eneavignoli/Dido/Thesis/arduino_mega_description.png

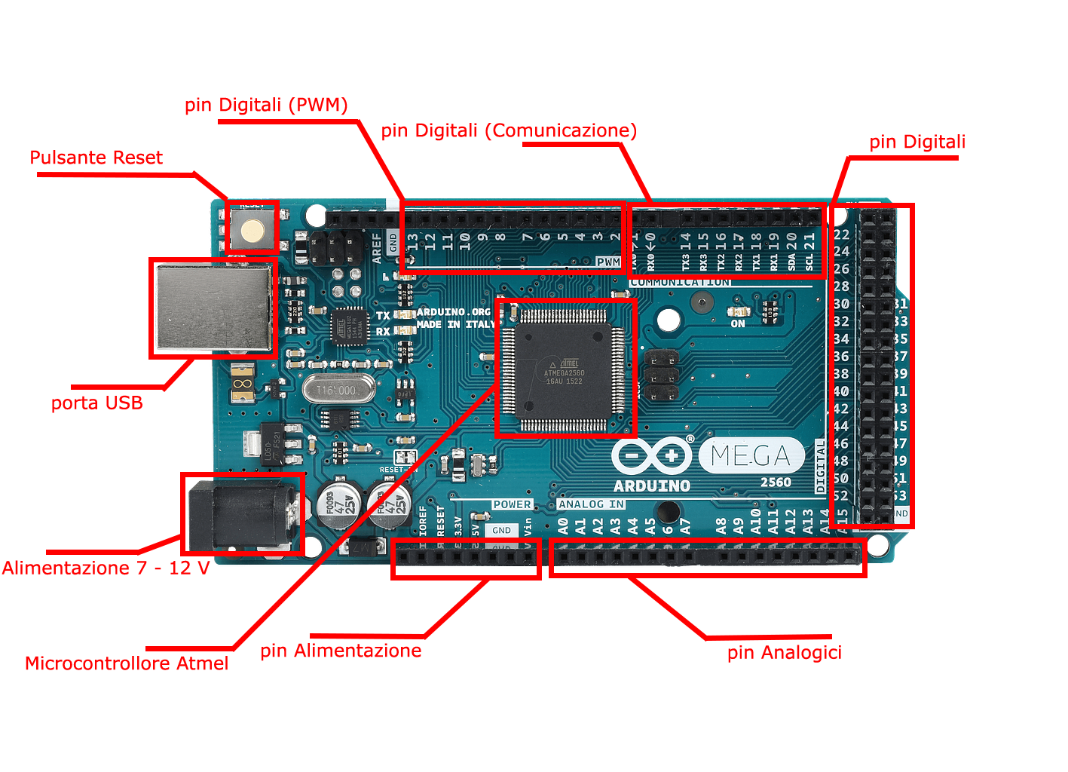
Thesis/arduino_mega_description.png
