eneavignoli/Dido/Thesis/view_board.JPG

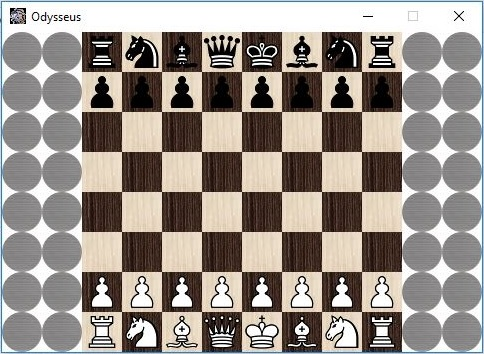
Thesis/view_board.JPG
