eneavignoli/Dido/Presentation/Odysseus.pptx

## Odysseus

Progettazione di un robot che gioca a scacchi

## Un po’ di storia

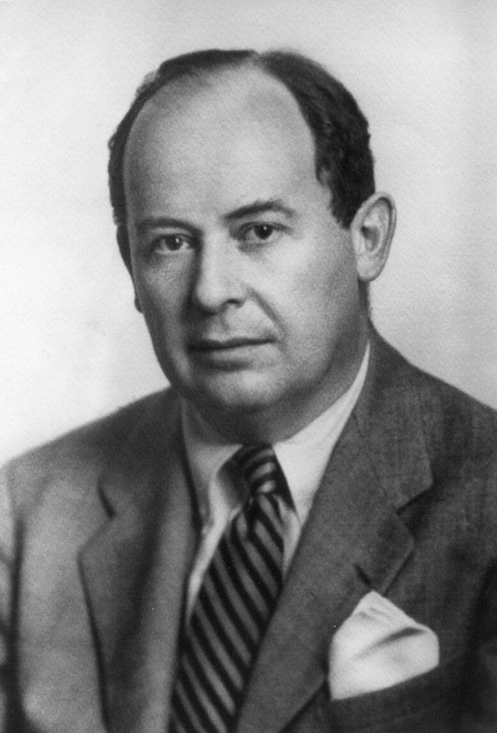
[picture p16: figure]

John Von Neumann

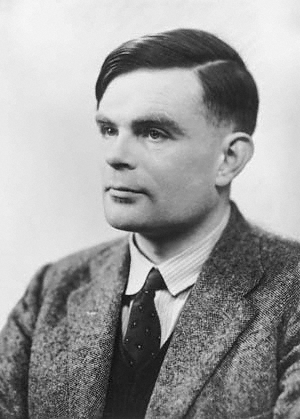
[picture p17: figure]

Alan Turing

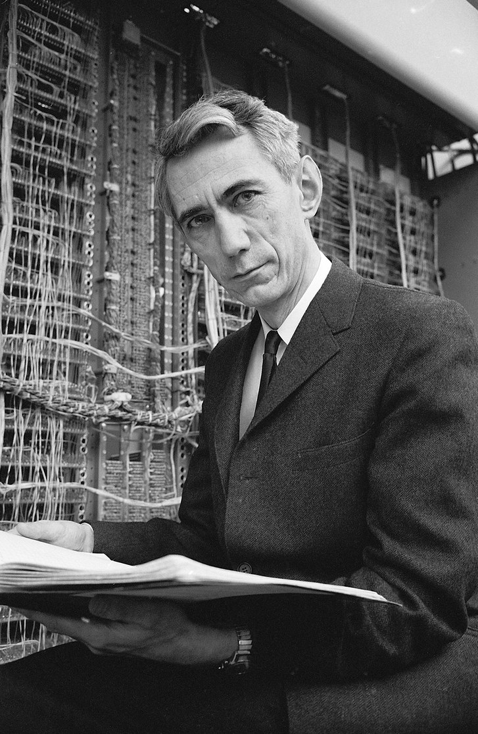
[picture p18: figure]

Claude Shannon

## Uomo e macchina si incontrano

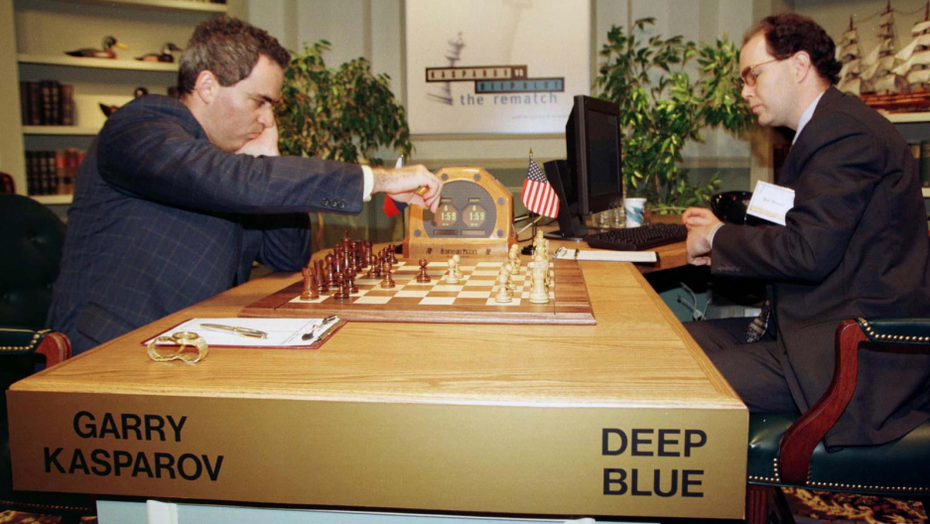
[picture p19: figure]

## Elaboratori


Raspberry Pi 3 Model B


Arduino Mega 2560 Rev3

## Matrice di rilevamento


## Sistema di spostamento

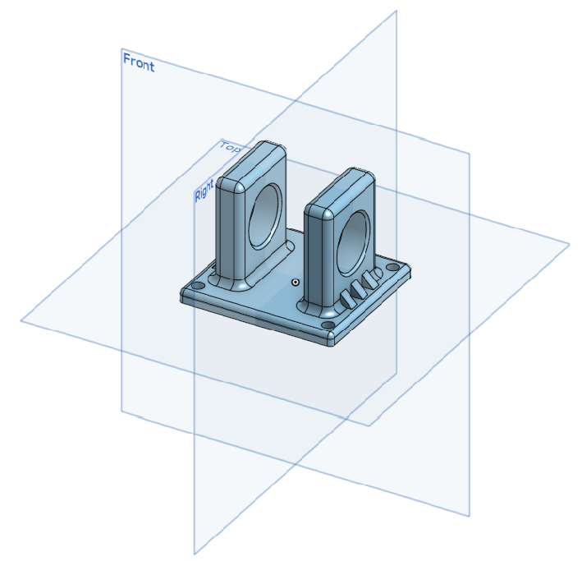
[picture p20: figure]

## Alberi di ricerca

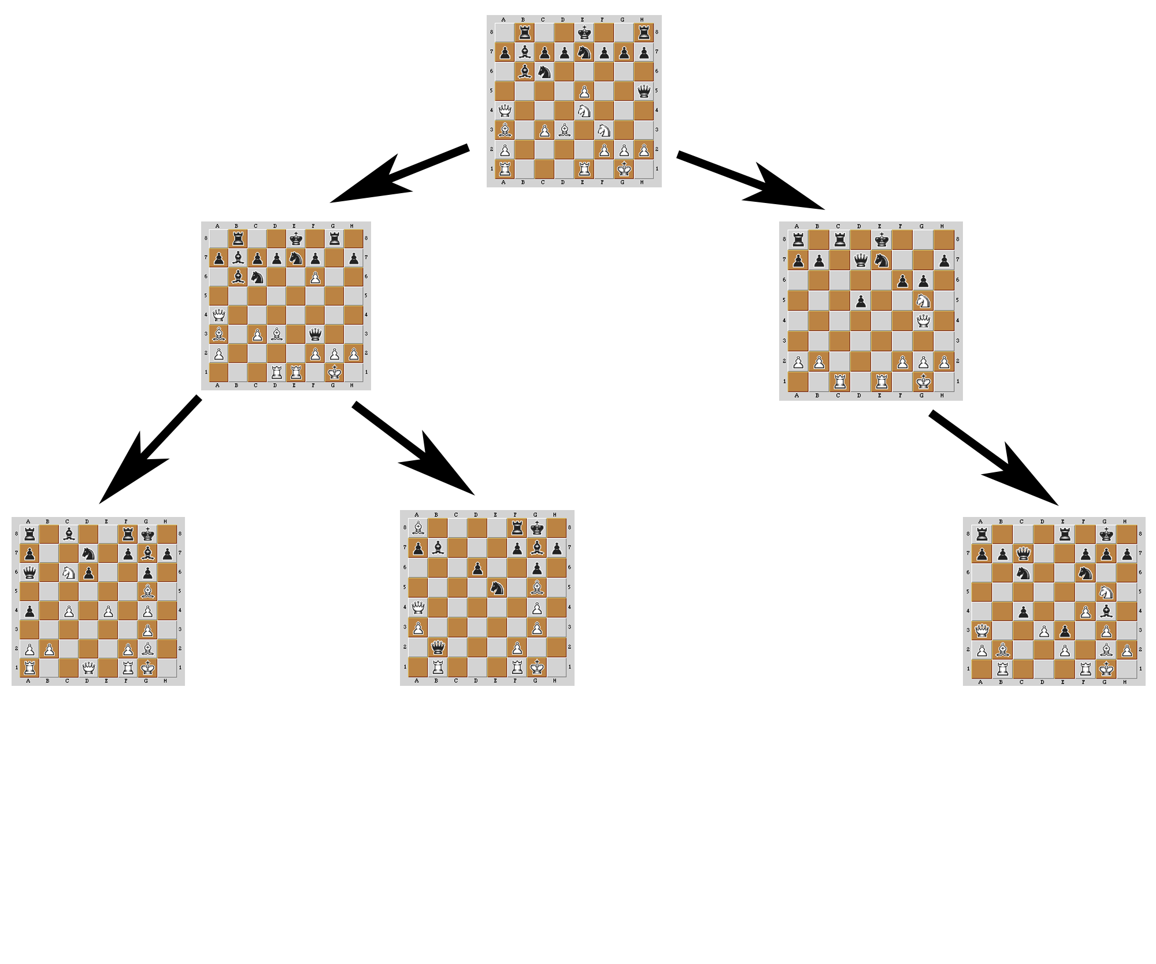
[picture p21: figure]

Nodo «Radice»

Nodi «Foglia»

## Algoritmo Minimax

5

5

-7

10

5

-7
