eneavignoli/Dido/Presentation/garry_kasparov.jpg

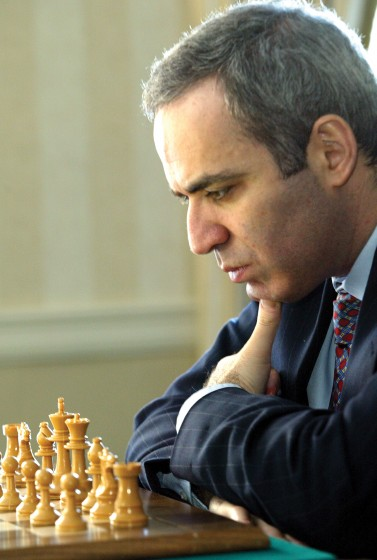
Presentation/garry_kasparov.jpg
