eneavignoli/Dido/Presentation/scacchiera1.gif

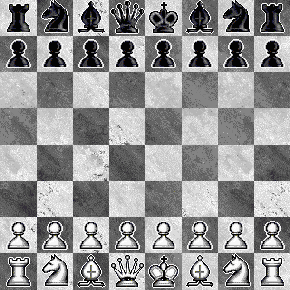
Presentation/scacchiera1.gif
