eneavignoli/Dido/Presentation/scacchiera2.gif

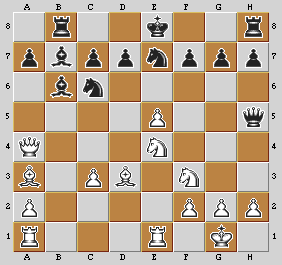
Presentation/scacchiera2.gif
