eneavignoli/Dido/Presentation/scacchiera3.gif

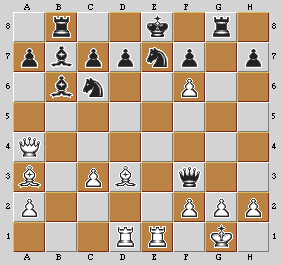
Presentation/scacchiera3.gif
