eneavignoli/Dido/Presentation/scacchiera4.gif

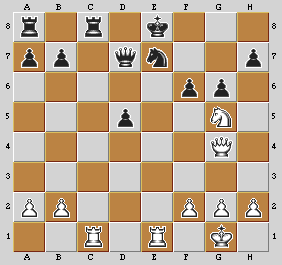
Presentation/scacchiera4.gif
