eneavignoli/Dido/Presentation/scacchiera5.gif

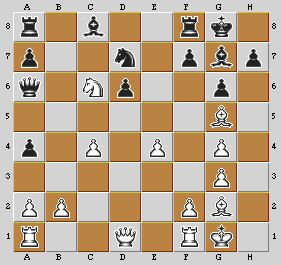
Presentation/scacchiera5.gif
