eneavignoli/Dido/Presentation/scacchiera6.gif

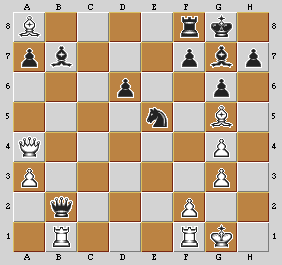
Presentation/scacchiera6.gif
