eneavignoli/Dido/Presentation/scacchiera7.gif

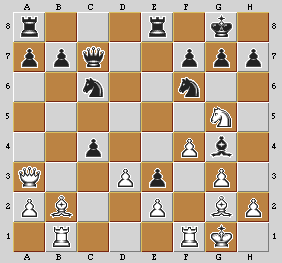
Presentation/scacchiera7.gif
