eneavignoli/Dido/Presentation/scacchiera8.gif

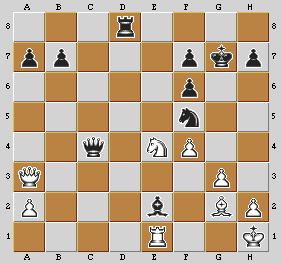
Presentation/scacchiera8.gif
