eneavignoli/Dido/Thesis/electronics_scheme.JPG

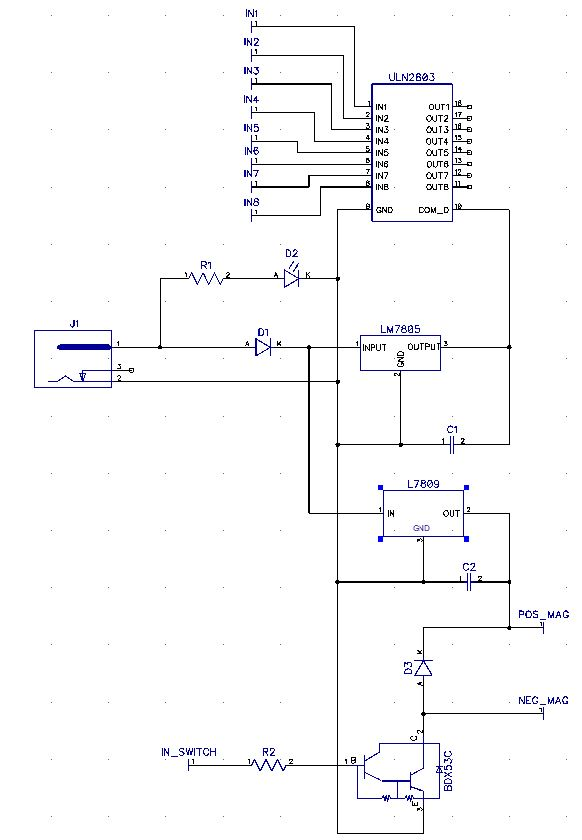
Thesis/electronics_scheme.JPG
