eneavignoli/Dido/Thesis/hall_data.JPG

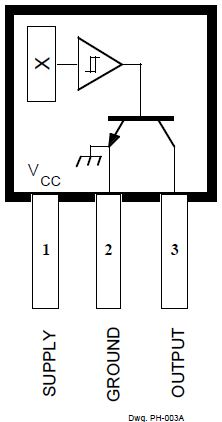
Thesis/hall_data.JPG
