eneavignoli/Dido/Thesis/isytozero.JPG

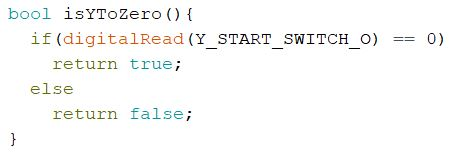
Thesis/isytozero.JPG
