eneavignoli/Dido/Thesis/kumantech_display.jpg

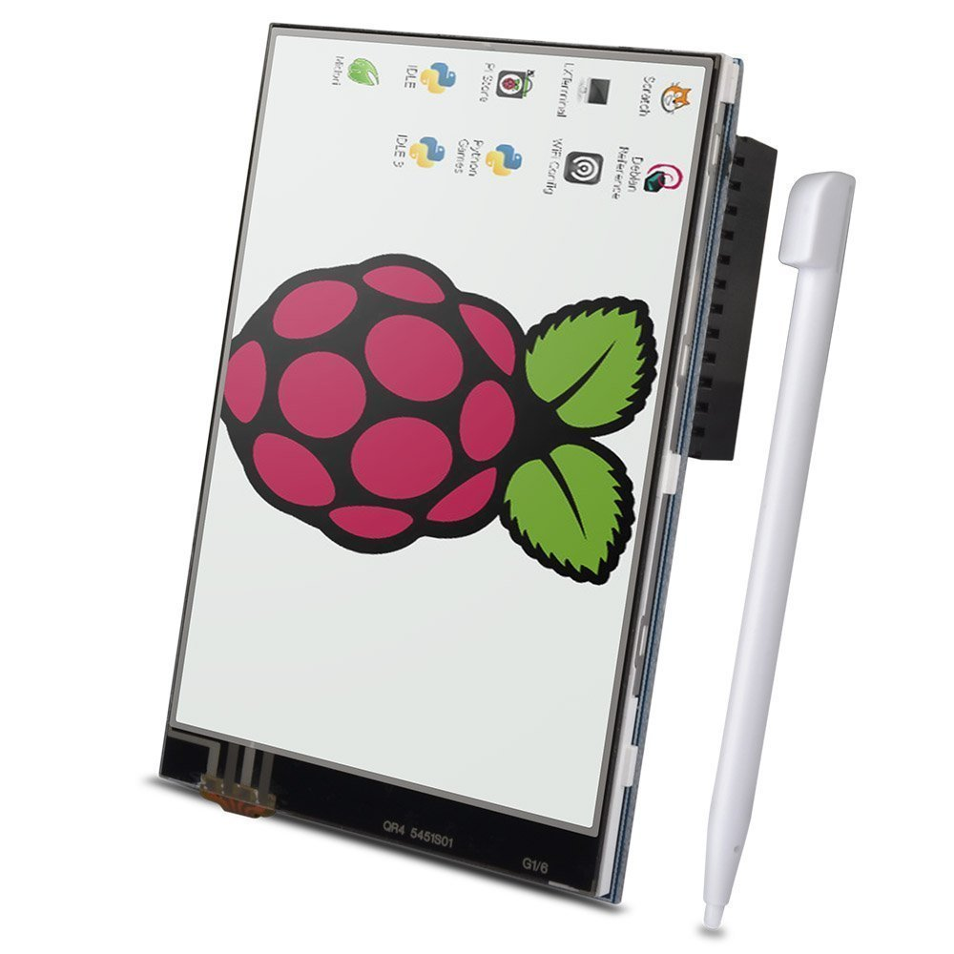
Thesis/kumantech_display.jpg
