eneavignoli/Dido/Thesis/raspberry_pi.png

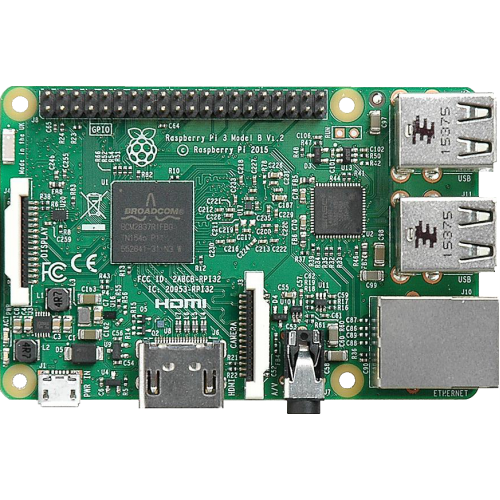
Thesis/raspberry_pi.png
