eneavignoli/Dido/Thesis/read_board_code.JPG

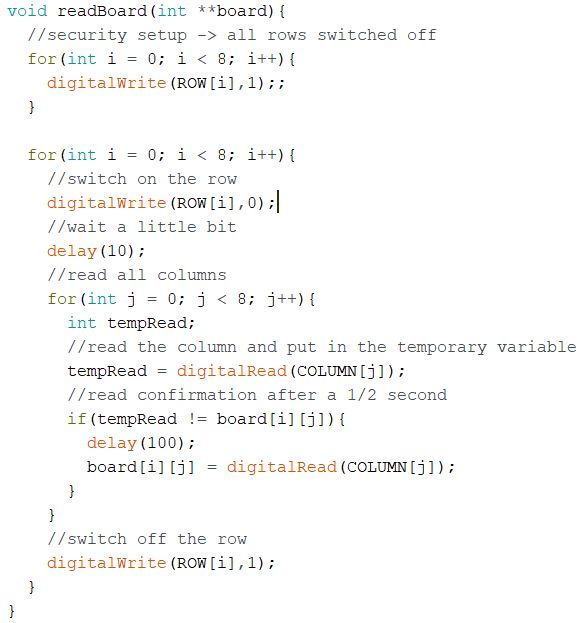
Thesis/read_board_code.JPG
