eneavignoli/Dido/SketchUp Projects/14 - Sostegno per stepper foro spostato.stl

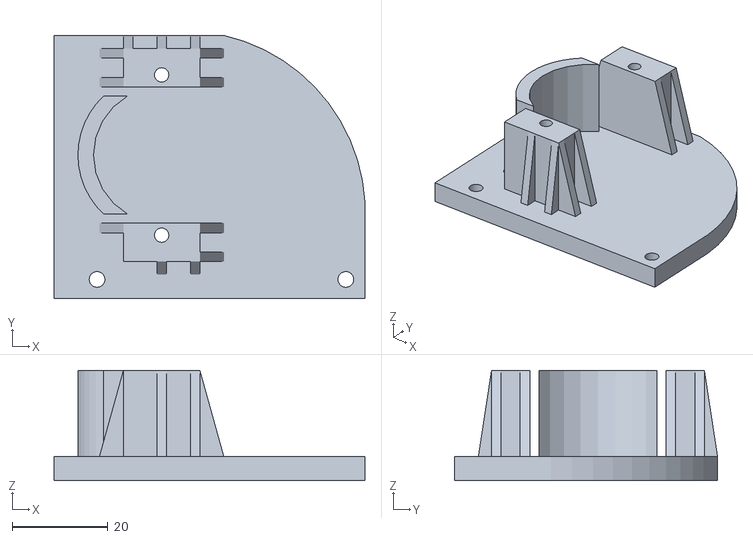
[picture p45: CAD file, 2018-05-31]
SketchUp Projects/14 - Sostegno per stepper foro spostato.stl
65.0 x 55.0 x 23.0
