eneavignoli/Dido/SketchUp Projects/13 - Sostegno per Perno Puleggia.stl

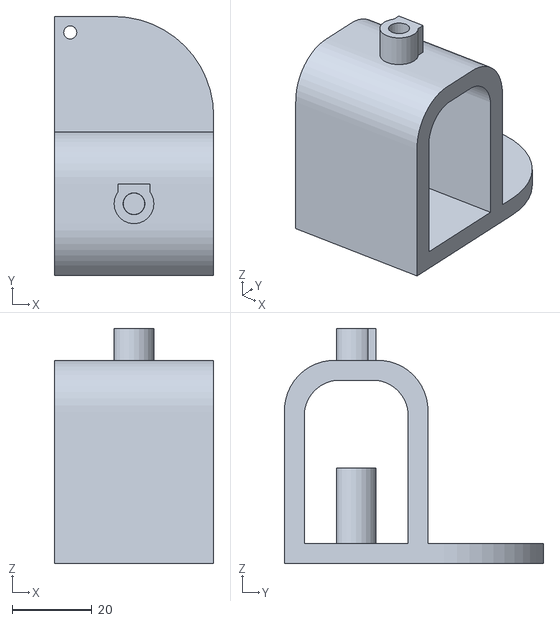
[picture p46: CAD file, 2018-05-31]
SketchUp Projects/13 - Sostegno per Perno Puleggia.stl
40.0 x 65.0 x 59.0
