eneavignoli/Dido/SketchUp Projects/11 - Fermo Cinghia Centrale.stl

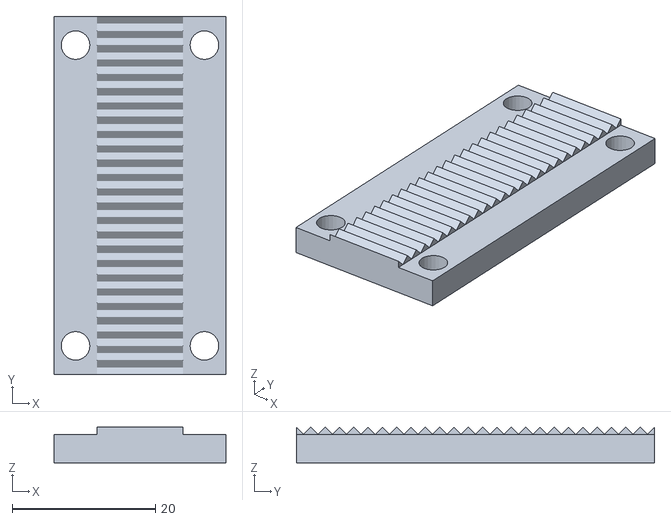
[picture p47: CAD file, 2018-04-13]
SketchUp Projects/11 - Fermo Cinghia Centrale.stl
24.0 x 50.0 x 5.00
