eneavignoli/Dido/SketchUp Projects/06 - Guida per Sostegno Stepper.stl

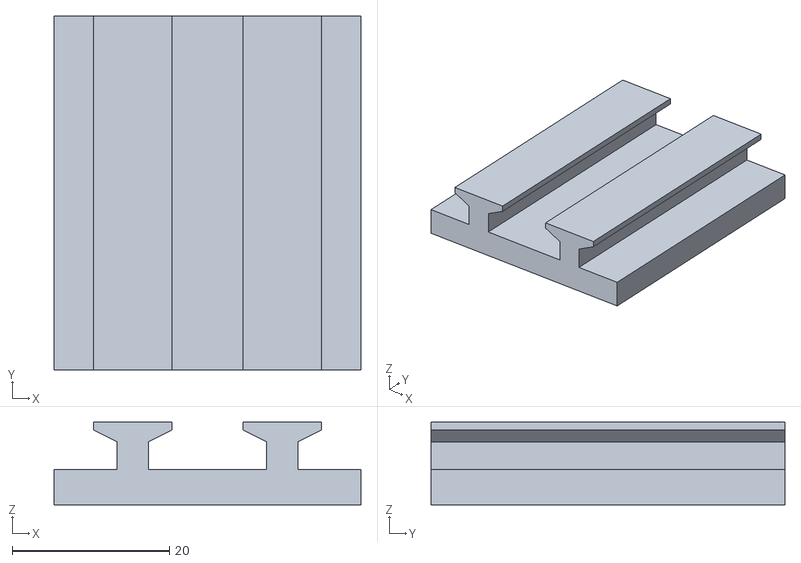
[picture p48: CAD file, 2018-04-13]
SketchUp Projects/06 - Guida per Sostegno Stepper.stl
39.0 x 45.0 x 10.5
