eneavignoli/Dido/SketchUp Projects/02 - Laterale  NO Cinghia.stl

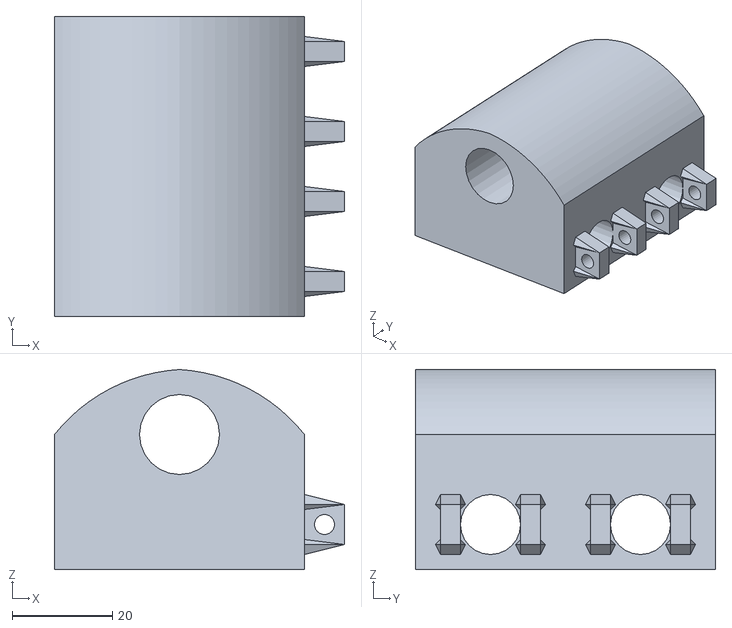
[picture p49: CAD file, 2018-04-13]
SketchUp Projects/02 - Laterale NO Cinghia.stl
58.0 x 60.0 x 40.0
