eneavignoli/Dido/SketchUp Projects/10 - Centrale.stl

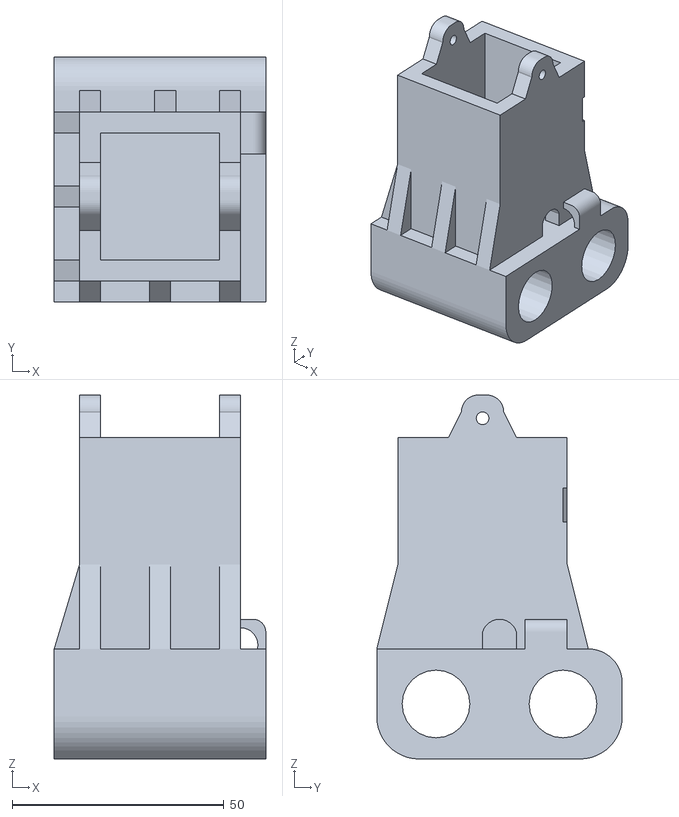
[picture p50: CAD file, 2018-04-13]
SketchUp Projects/10 - Centrale.stl
50.0 x 58.0 x 86.0
