eneavignoli/Dido/SketchUp Projects/09 - Sostegno per stepper STRETTO.stl

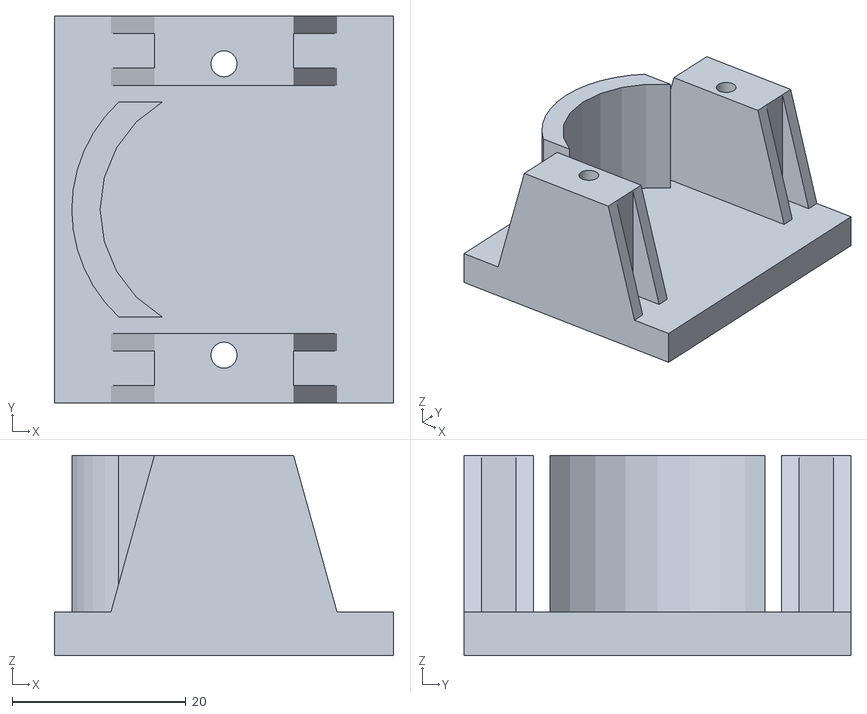
[picture p51: CAD file, 2018-04-13]
SketchUp Projects/09 - Sostegno per stepper STRETTO.stl
39.0 x 44.5 x 23.0
