eneavignoli/Dido/SketchUp Projects/08 - Sostegno per laterale CON GUIDA.stl

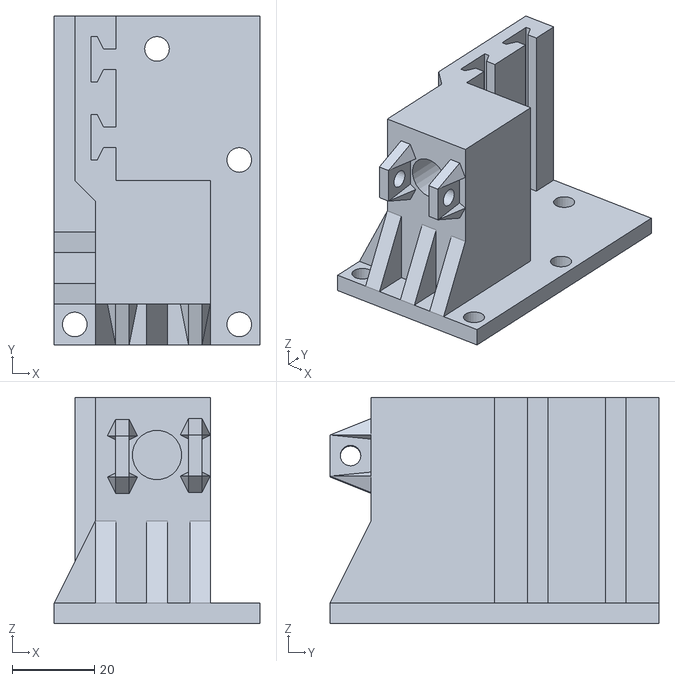
[picture p52: CAD file, 2018-04-13]
SketchUp Projects/08 - Sostegno per laterale CON GUIDA.stl
50.0 x 80.0 x 55.0
