eneavignoli/Dido/SketchUp Projects/04 - Sostegno per laterale BASE.stl

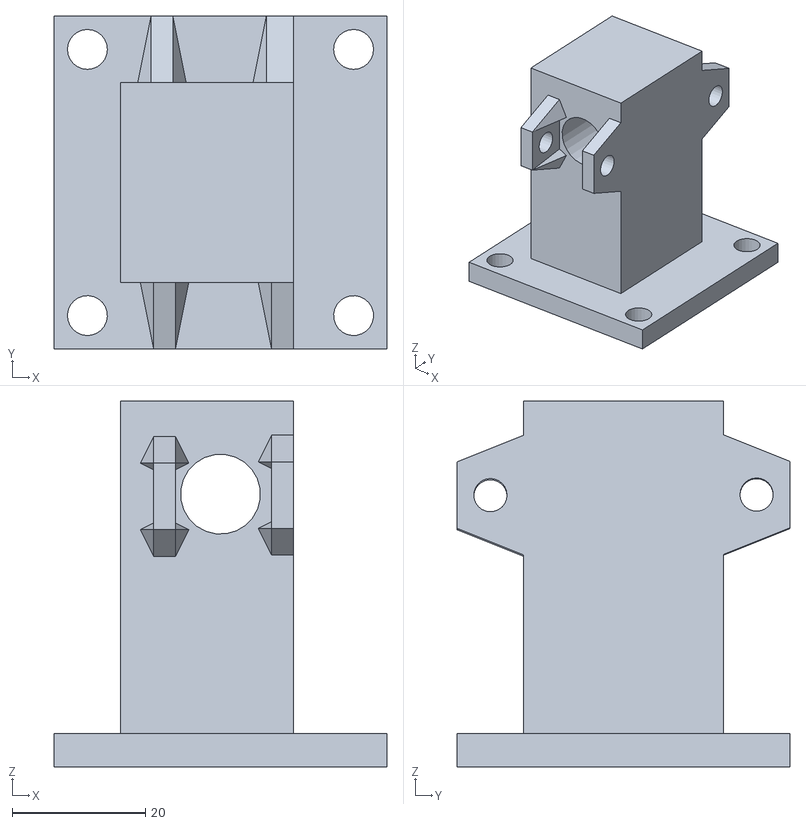
[picture p53: CAD file, 2018-04-13]
SketchUp Projects/04 - Sostegno per laterale BASE.stl
50.0 x 50.0 x 55.0
