eneavignoli/Dido/SketchUp Projects/07 - Sostegno per stepper.stl

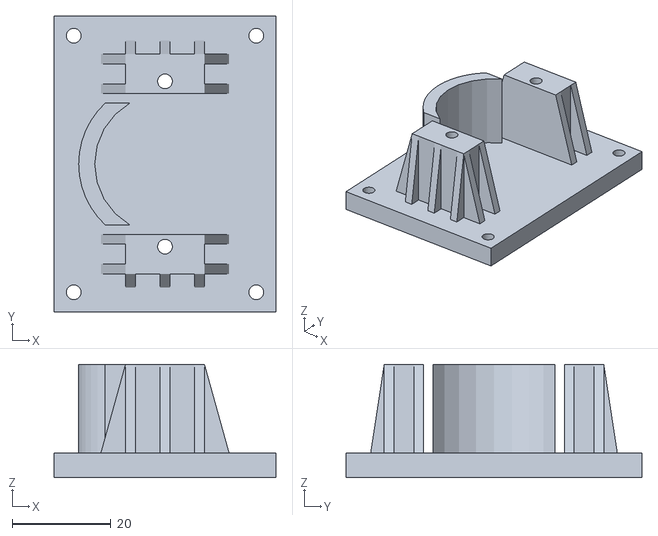
[picture p54: CAD file, 2018-04-13]
SketchUp Projects/07 - Sostegno per stepper.stl
45.0 x 60.0 x 23.0
