eneavignoli/Dido/(list of files, cad)

Other CAD files:
SketchUp Projects/01 - Laterale Cinghia.skp
SketchUp Projects/02 - Laterale NO Cinghia.skp
SketchUp Projects/03 - Fermo Cinghia.skp
SketchUp Projects/04 - Sostegno per laterale BASE.skp
SketchUp Projects/05 - Sostegno per laterale MOTORE.skp
SketchUp Projects/06 - Guida per Sostegno Stepper.skp
SketchUp Projects/07 - Sostegno per stepper.skp
SketchUp Projects/08 - Sostegno per laterale CON GUIDA.skp
SketchUp Projects/09 - Sostegno per stepper STRETTO.skp
SketchUp Projects/10 - Centrale.skp
SketchUp Projects/11 - Fermo Cinghia Centrale.skp
SketchUp Projects/12.skp
SketchUp Projects/13 - Sostegno per Perno Puleggia.skp
SketchUp Projects/14 - Sostegno per stepper foro spostato.skp
