eneavignoli/Dido/(list of files, drawings)

Other design files:
Electrical_Schemes/chessboard.dch
Electrical_Schemes/elettromagnete.dch
Electrical_Schemes/pcb esame.dip
Electrical_Schemes/progetto esame.dch
