eneavignoli/Dido/(commit log)

2018-04-13 Modifica nome progetto e file sketchup
    [01 - Laterale Cinghia.skp, 02 - Laterale NO Cinghia.skp, 02 - Laterale NO Cinghia.stl, 03 - Fermo Cinghia.skp, 04 - Sostegno per laterale BASE.skp, 04 - Sostegno per laterale BASE.stl, 05 - Sostegno per laterale MOTORE.skp, 06 - Guida per Sostegno Stepper.skp]
2018-05-31 Aggiunta Tesi e Software
    [13 - Sostegno per Perno Puleggia.skp, 13 - Sostegno per Perno Puleggia.stl, 14 - Sostegno per stepper foro spostato.skp, 14 - Sostegno per stepper foro spostato.stl]
2018-06-16 Aggiunto Elaborato Tesina
    [chessboard.dch]
